Klein-s-Playground/octo-pcb/README.md

# octo-pcb
KiCAD projects for PCB design files
