Klein-s-Playground/octo-pcb/diff-rcvr/README.md

# diff-rcvr

Single unidirectional RS-485/RS-422 differential to single-ended receiver.

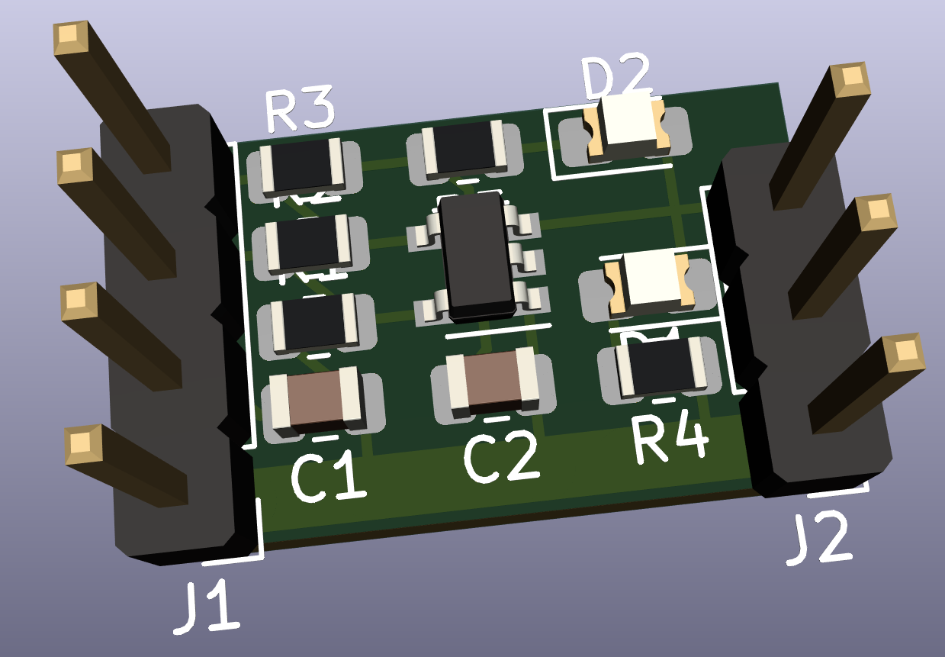
[picture p5: diff-rcvr/img/diff-rcvr_3d.png]
diff-rvcr_3d


This 10x20mm PCB is designed to be soldered on or near a strip of WS2812B programmable LEDs to increase the range and improve noise immunity on the data line.

| Schematic | PCB Layout |
:-------------------------:|:-------------------------:
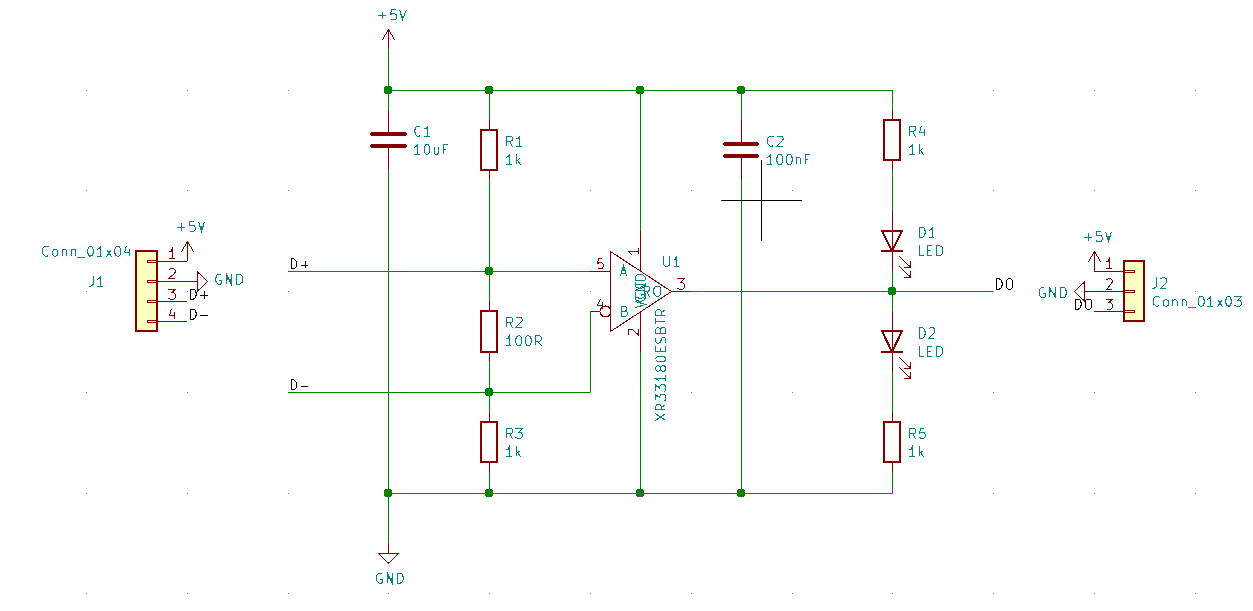
[picture p6: diff-rcvr/img/diff-rcvr_sch.png]
diff-rvcr_sch
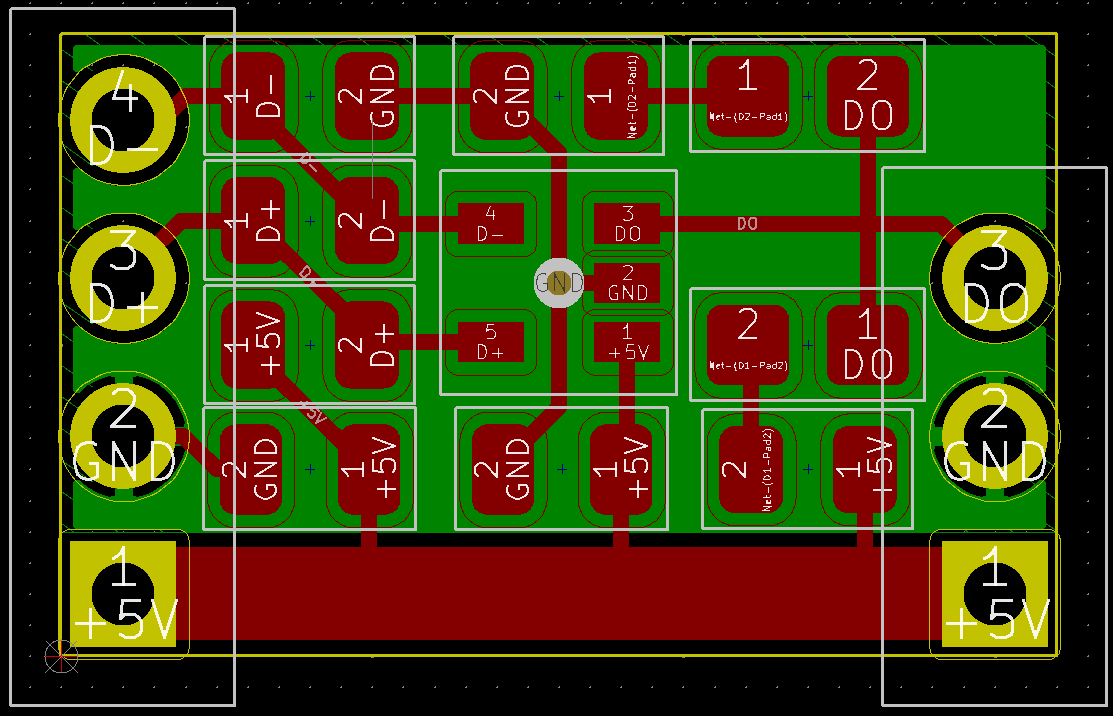
[picture p7: diff-rcvr/img/diff-rcvr_brd.png]
diff-rvcr_brd
 |
