Klein-s-Playground/octo-pcb/quad-diff-drvr/img/quad-diff-drvr.pdf

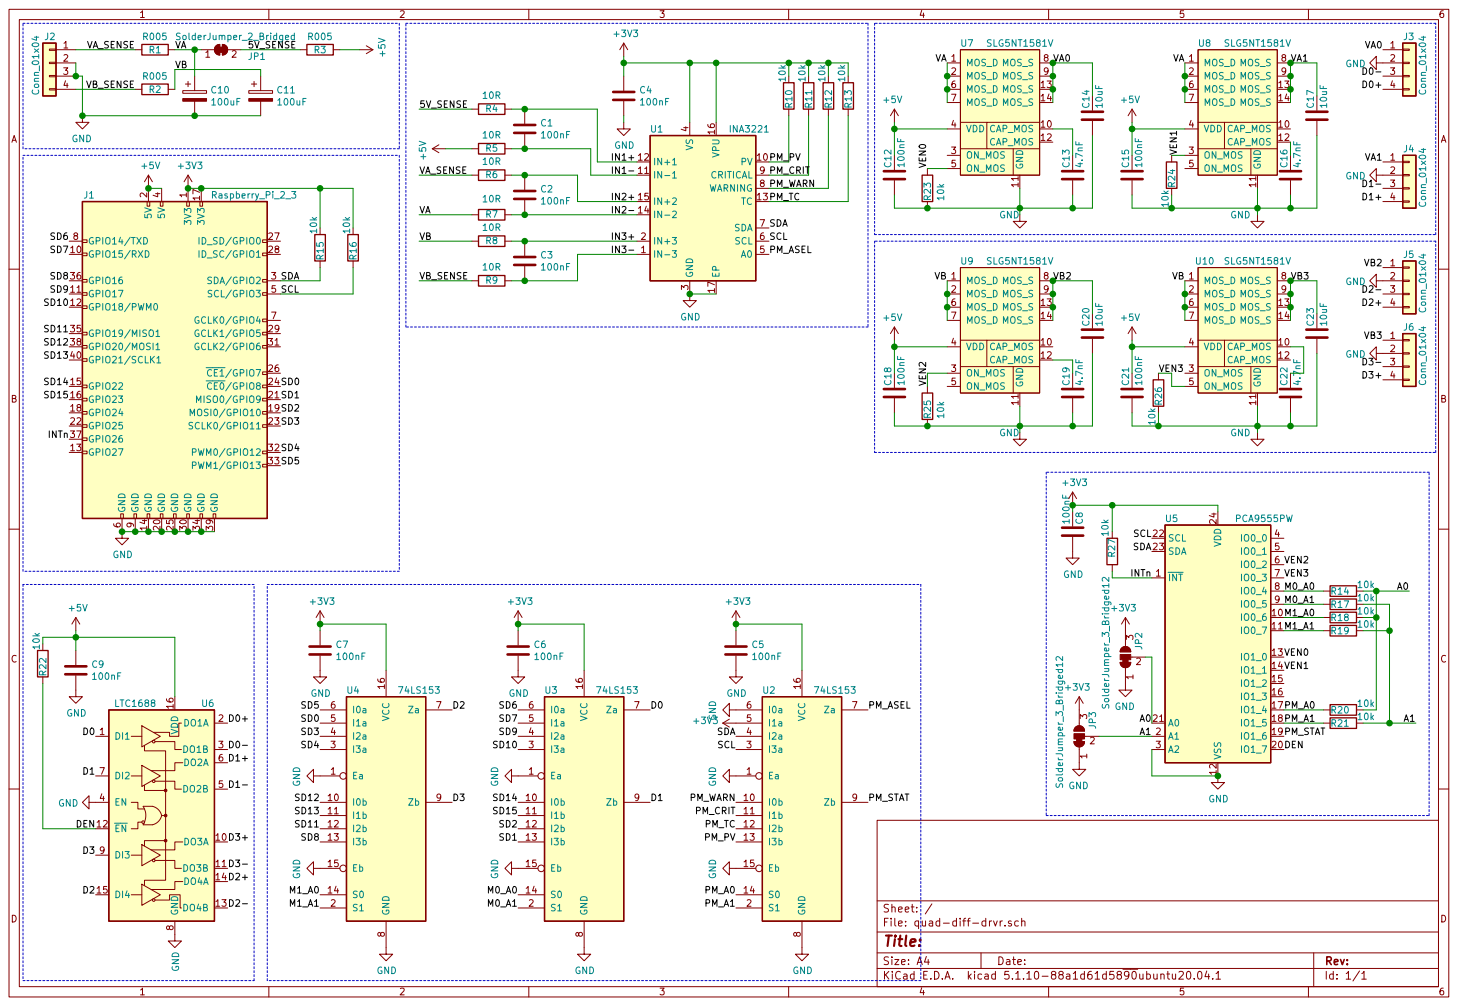
[picture p8: page 1]

3 JP3 SolderJumper_3_Bridged12 R14 10k R17 10k R18 10k R19 10k GND C12 100nF GND GND GND C13 4.7nF GND MOS_D 1 CAP_MOS 10 GND 11 CAP_MOS 12 MOS_S 13 MOS_S 14 MOS_D 2 ON_MOS 3 VDD 4 ON_MOS 5 MOS_D 6 MOS_D 7 MOS_S 8 MOS_S 9 U7 SLG5NT1581V

4 A0 5 SCL 6 SDA 7 WARNING 8 CRITICAL 9 U1 INA3221 R10 10k

File: quad-diff-drvr.sch Sheet: /
Rev: | D Date: KiCad E.D.A. kicad 5.1.10-88a1d61d5890ubuntu20.04.1 Size: A4
