Klein-s-Playground/octo-pcb/quad-diff-drvr/quad-diff-drvr.kicad_pcb

## KiCad design quad-diff-drvr/quad-diff-drvr.kicad_pcb (2022-01-29)

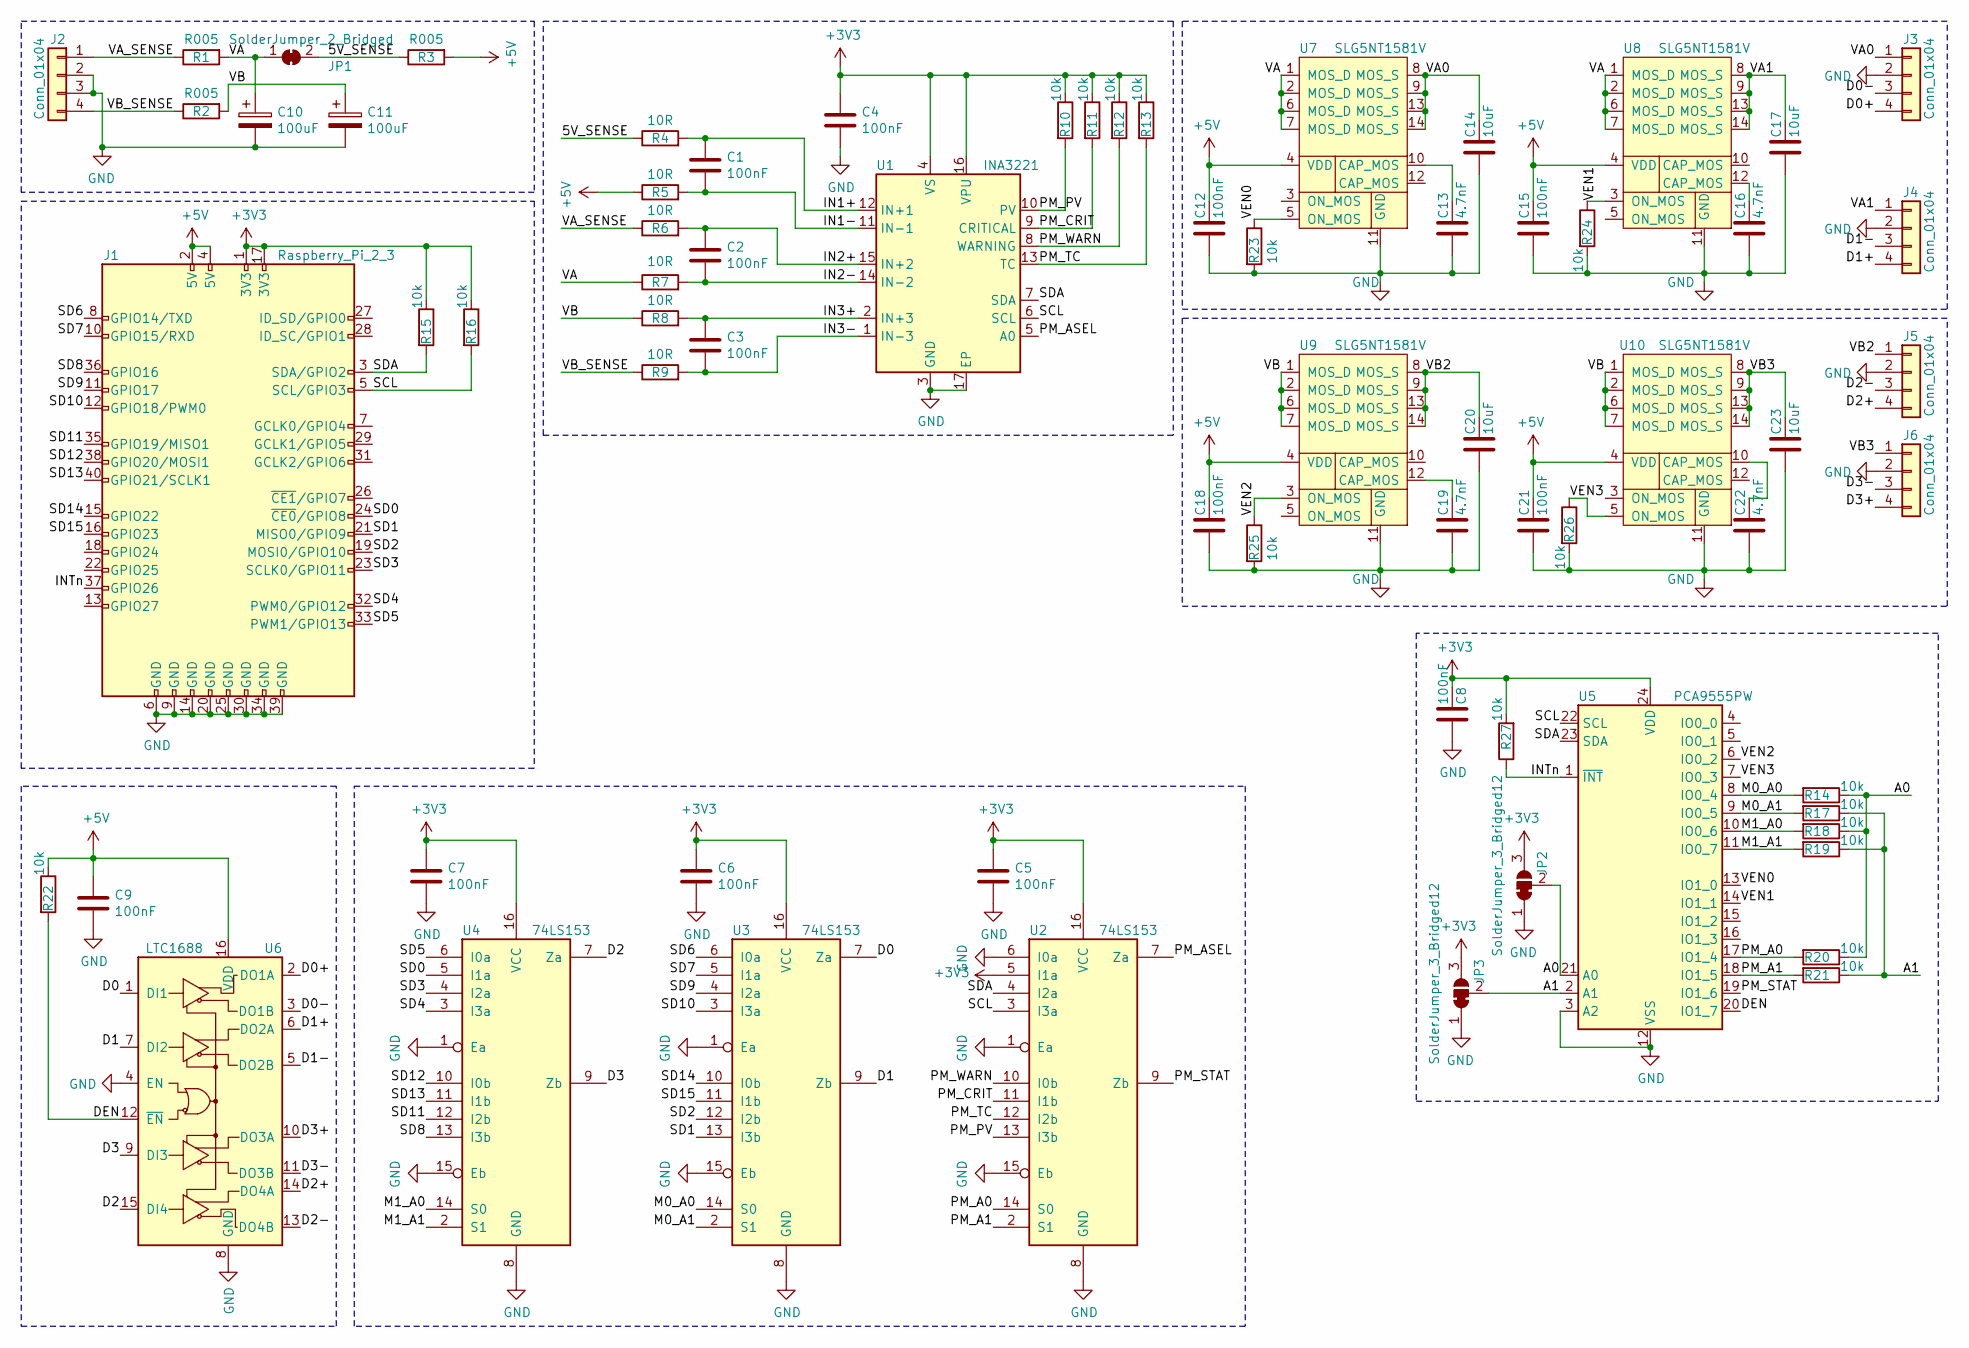
[picture p9: schematic quad-diff-drvr.sch]

Parts:
C1, C2, C3, C4, C5, C6, C7, C8, C9, C12, C15, C18, C21: 100nF; C_0603_1608Metric
C10, C11: 100uF; CP_Elec_6.3x7.7
C13, C16, C19, C22: 4.7nF; C_0603_1608Metric
C14, C17, C20, C23: 10uF; C_1206_3216Metric
J1: Raspberry_Pi_2_3; PinHeader_2x20_P2.54mm_Vertical
J2, J3, J4, J5, J6: Conn_01x04; PhoenixContact_MSTBA_2,5_4-G_1x04_P5.00mm_Horizontal
JP1: SolderJumper_2_Bridged; SolderJumper-2_P1.3mm_Bridged2Bar_RoundedPad1.0x1.5mm
JP2, JP3: SolderJumper_3_Bridged12; SolderJumper-3_P1.3mm_Bridged2Bar12_RoundedPad1.0x1.5mm
R1, R2, R3: R005; R_1206_3216Metric
R4, R5, R6, R7, R8, R9: 10R; R_0603_1608Metric
R10, R11, R12, R13, R14, R15, R16, R17, R18, R19, R20, R21, R22, R23, R24, R25, R26, R27: 10k; R_0603_1608Metric
U1: INA3221; Texas_RGV_S-PVQFN-N16_EP2.1x2.1mm
U2, U3, U4: 74LS153; TSSOP-16_4.4x5mm_P0.65mm
U5: PCA9555PW; TSSOP-24_4.4x7.8mm_P0.65mm
U6: LTC1688; SOIC-16_3.9x9.9mm_P1.27mm
U7, U8, U9, U10: SLG5NT1581V; QFN-28_1x3_Pitch0.4mm

Connections:
+3V3: C4.1, C5.1, C6.1, C7.1, C8.1, J1.1 (3V3), J1.17 (3V3), JP2.3 (B), JP3.3 (B), R10.1, R11.1, R12.1, R13.1, R15.1, R16.1, R27.2, U1.4 (VS), U1.16 (VPU), U2.5 (I1a), U2.16 (VCC), U3.16 (VCC), U4.16 (VCC), U5.24 (VDD)
+5V: C9.1, C12.1, C15.1, C18.1, C21.1, J1.2 (5V), J1.4 (5V), R3.2, R5.1, R22.1, U6.16 (VDD), U7.4 (VDD), U8.4 (VDD), U9.4 (VDD), U10.4 (VDD)
/5V_SENSE: JP1.2 (B), R3.1, R4.1
/A0: JP2.2 (C), R14.1, R18.1, R20.1, U5.21 (A0)
/A1: JP3.2 (C), R17.1, R19.1, R21.1, U5.2 (A1)
/D0: U3.7 (Za), U6.1 (DI1)
/D0+: J3.4, U6.2 (DO1A)
/D0-: J3.3, U6.3 (DO1B)
/D1: U3.9 (Zb), U6.7 (DI2)
/D1+: J4.4, U6.6 (DO2A)
/D1-: J4.3, U6.5 (DO2B)
/D2: U4.7 (Za), U6.15 (DI4)
/D2+: J5.4, U6.14 (DO4A)
/D2-: J5.3, U6.13 (DO4B)
/D3: U4.9 (Zb), U6.9 (DI3)
/D3+: J6.4, U6.10 (DO3A)
/D3-: J6.3, U6.11 (DO3B)
/DEN: R22.2, U5.20 (IO1_7), U6.12 (~EN)
/IN1+: C1.1, R4.2, U1.12 (IN+1)
/IN1-: C1.2, R5.2, U1.11 (IN-1)
/IN2+: C2.1, R6.2, U1.15 (IN+2)
/IN2-: C2.2, R7.2, U1.14 (IN-2)
/IN3+: C3.1, R8.2, U1.2 (IN+3)
/IN3-: C3.2, R9.2, U1.1 (IN-3)
/INTn: J1.37 (GPIO26), R27.1, U5.1 (~INT)
/M0_A0: R14.2, U3.14 (S0), U5.8 (IO0_4)
/M0_A1: R17.2, U3.2 (S1), U5.9 (IO0_5)
/M1_A0: R18.2, U4.14 (S0), U5.10 (IO0_6)
/M1_A1: R19.2, U4.2 (S1), U5.11 (IO0_7)
/PM_A0: R20.2, U2.14 (S0), U5.17 (IO1_4)
/PM_A1: R21.2, U2.2 (S1), U5.18 (IO1_5)
/PM_ASEL: U1.5 (A0), U2.7 (Za)
/PM_CRIT: R11.2, U1.9 (CRITICAL), U2.11 (I1b)
/PM_PV: R10.2, U1.10 (PV), U2.13 (I3b)
/PM_STAT: U2.9 (Zb), U5.19 (IO1_6)
/PM_TC: R13.2, U1.13 (TC), U2.12 (I2b)
/PM_WARN: R12.2, U1.8 (WARNING), U2.10 (I0b)
/SCL: J1.5 (SCL/GPIO3), R16.2, U1.6 (SCL), U2.3 (I3a), U5.22 (SCL)
/SD0: J1.24 (~CE0~/GPIO8), U4.5 (I1a)
/SD1: J1.21 (MISO0/GPIO9), U3.13 (I3b)
/SD2: J1.19 (MOSI0/GPIO10), U3.12 (I2b)
/SD3: J1.23 (SCLK0/GPIO11), U4.4 (I2a)
/SD4: J1.32 (PWM0/GPIO12), U4.3 (I3a)
/SD5: J1.33 (PWM1/GPIO13), U4.6 (I0a)
/SD6: J1.8 (GPIO14/TXD), U3.6 (I0a)
/SD7: J1.10 (GPIO15/RXD), U3.5 (I1a)
/SD8: J1.36 (GPIO16), U4.13 (I3b)
/SD9: J1.11 (GPIO17), U3.4 (I2a)
/SD10: J1.12 (GPIO18/PWM0), U3.3 (I3a)
/SD11: J1.35 (GPIO19/MISO1), U4.12 (I2b)
/SD12: J1.38 (GPIO20/MOSI1), U4.10 (I0b)
/SD13: J1.40 (GPIO21/SCLK1), U4.11 (I1b)
/SD14: J1.15 (GPIO22), U3.10 (I0b)
/SD15: J1.16 (GPIO23), U3.11 (I1b)
/SDA: J1.3 (SDA/GPIO2), R15.2, U1.7 (SDA), U2.4 (I2a), U5.23 (SDA)
/VA: C10.1, JP1.1 (A), R1.2, R7.1, U7.1 (MOS_D), U7.2 (MOS_D), U7.6 (MOS_D), U7.7 (MOS_D), U8.1 (MOS_D), U8.2 (MOS_D), U8.6 (MOS_D), U8.7 (MOS_D)
/VA0: C14.1, J3.1, U7.8 (MOS_S), U7.9 (MOS_S), U7.13 (MOS_S), U7.14 (MOS_S)
/VA1: C17.1, J4.1, U8.8 (MOS_S), U8.9 (MOS_S), U8.13 (MOS_S), U8.14 (MOS_S)
/VA_SENSE: J2.1, R1.1, R6.1
/VB: C11.1, R2.2, R8.1, U9.1 (MOS_D), U9.2 (MOS_D), U9.6 (MOS_D), U9.7 (MOS_D), U10.1 (MOS_D), U10.2 (MOS_D), U10.6 (MOS_D), U10.7 (MOS_D)
/VB2: C20.1, J5.1, U9.8 (MOS_S), U9.9 (MOS_S), U9.13 (MOS_S), U9.14 (MOS_S)
/VB3: C23.1, J6.1, U10.8 (MOS_S), U10.9 (MOS_S), U10.13 (MOS_S), U10.14 (MOS_S)
/VB_SENSE: J2.4, R2.1, R9.1
/VEN0: R23.1, U5.13 (IO1_0), U7.5 (ON_MOS)
/VEN1: R24.1, U5.14 (IO1_1), U8.3 (ON_MOS)
/VEN2: R25.1, U5.6 (IO0_2), U9.3 (ON_MOS)
/VEN3: R26.1, U5.7 (IO0_3), U10.5 (ON_MOS)
GND: C4.2, C5.2, C6.2, C7.2, C8.2, C9.2, C10.2, C11.2, C12.2, C13.2, C14.2, C15.2, C16.2, C17.2, C18.2, C19.2, C20.2, C21.2, C22.2, C23.2, J1.6 (GND), J1.9 (GND), J1.14 (GND), J1.20 (GND), J1.25 (GND), J1.30 (GND), J1.34 (GND), J1.39 (GND), J2.2, J2.3, J3.2, J4.2, J5.2, J6.2, JP2.1 (A), JP3.1 (A), R23.2, R24.2, R25.2, R26.2, U1.3 (GND), U1.17 (EP), U2.1 (Ea), U2.6 (I0a), U2.8 (GND), U2.15 (Eb), U3.1 (Ea), U3.8 (GND), U3.15 (Eb), U4.1 (Ea), U4.8 (GND), U4.15 (Eb), U5.3 (A2), U5.12 (VSS), U6.4 (EN), U6.8 (GND), U7.11 (GND), U8.11 (GND), U9.11 (GND), U10.11 (GND)
unnamed: C13.1, U7.10 (CAP_MOS)
unnamed: C16.1, U8.12 (CAP_MOS)
unnamed: C19.1, U9.12 (CAP_MOS)
unnamed: C22.1, U10.10 (CAP_MOS)

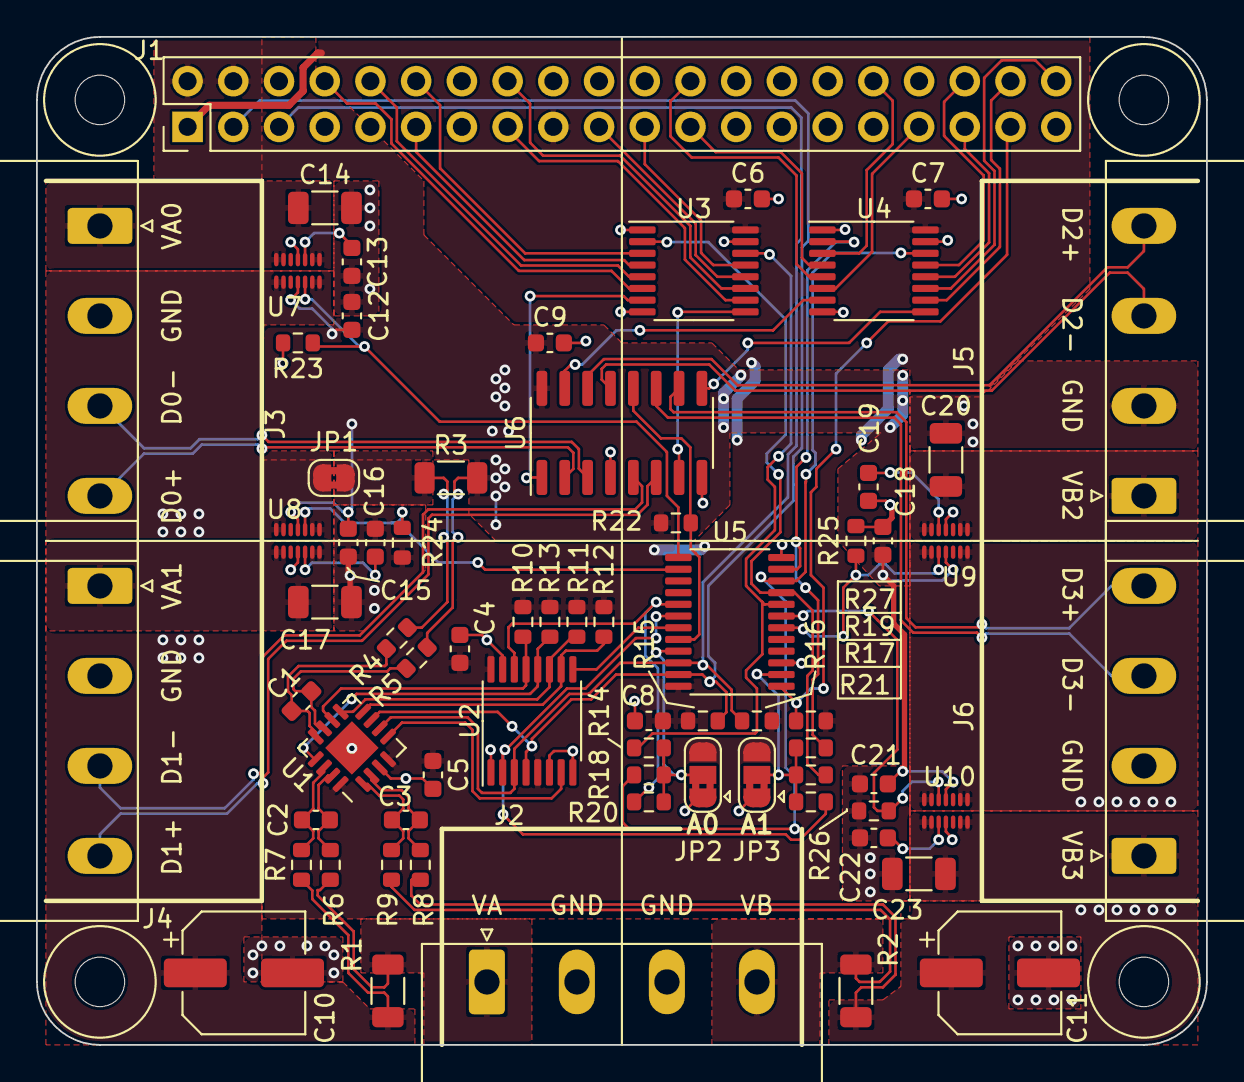
[picture p10: board quad-diff-drvr.kicad_pcb from above]

Board: 2 copper layers, 65.0 x 56.0 mm, 69 parts (0 on the bottom side), 72 nets.
