Klein-s-Playground/octo-pcb/diff-rcvr/diff-rcvr.kicad_pcb

## KiCad design diff-rcvr/diff-rcvr.kicad_pcb (2022-01-18)

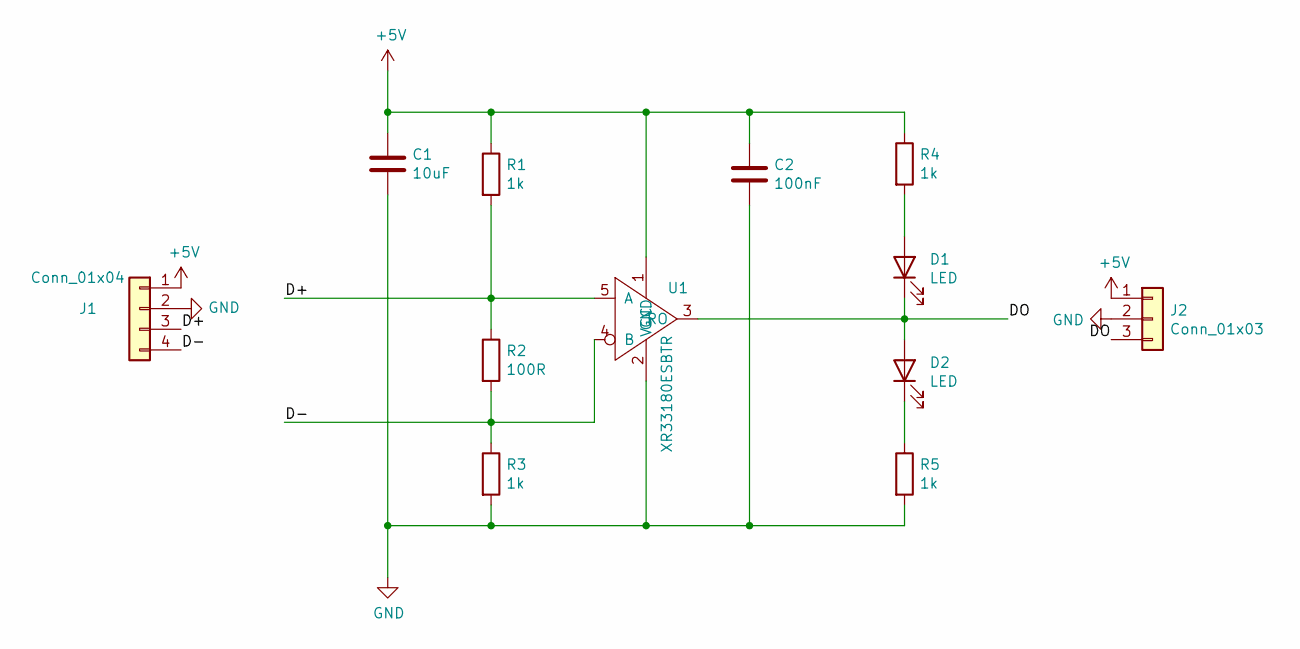
[picture p11: schematic diff-rcvr.sch]

Parts:
C1: 10uF; C_0805_2012Metric
C2: 100nF; C_0805_2012Metric
D1, D2: LED; LED_0805_2012Metric_Castellated
J1: Conn_01x04; PinHeader_1x04_P2.54mm_Vertical
J2: Conn_01x03; PinHeader_1x03_P2.54mm_Vertical
R1, R3, R4, R5: 1k; R_0805_2012Metric
R2: 100R; R_0805_2012Metric
U1: XR33180ESBTR; SOT-23-5

Connections:
+5V: C1.1, C2.1, J1.1, J2.1, R1.1, R4.1, U1.1 (VCC)
/D+: J1.3, R1.2, R2.1, U1.5 (A)
/D-: J1.4, R2.2, R3.1, U1.4 (B)
/DO: D1.1 (K), D2.2 (A), J2.3, U1.3 (RO)
GND: C1.2, C2.2, J1.2, J2.2, R3.2, R5.2, U1.2 (GND)
unnamed: D1.2 (A), R4.2
unnamed: D2.1 (K), R5.1

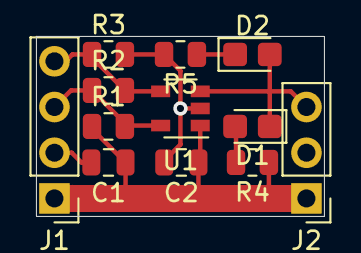
[picture p12: board diff-rcvr.kicad_pcb from above]

Board: 2 copper layers, 16.0 x 10.0 mm, 12 parts (0 on the bottom side), 7 nets.
