Klein-s-Playground/octo-pcb/(commit log)

2022-01-18 diff-rcvf: first commit
    [diff-rcvr.kicad_pcb, diff-rcvr.sch]
2022-01-22 qdd: basic mechanical layout done
    [quad-diff-drvr.kicad_pcb, quad-diff-drvr.sch]
2022-01-22 qdd: power monitor added
    [quad-diff-drvr.kicad_pcb, quad-diff-drvr.sch]
2022-01-22 qdd: add mux0 and mux1
    [quad-diff-drvr.kicad_pcb, quad-diff-drvr.sch]
2022-01-22 qd: GPIO expander in
    [quad-diff-drvr.kicad_pcb, quad-diff-drvr.sch]
2022-01-22 qdd: driver added
    [quad-diff-drvr.kicad_pcb, quad-diff-drvr.sch]
2022-01-24 qdd: first pass at routing
    [quad-diff-drvr.kicad_pcb, quad-diff-drvr.sch]
2022-01-24 qdd: adding high-side switch
    [quad-diff-drvr.sch]
2022-01-25 qdd: unsure what got out of sync
    [quad-diff-drvr.kicad_pcb, quad-diff-drvr.sch]
2022-01-25 qdd: stash wip
    [quad-diff-drvr.kicad_pcb, quad-diff-drvr.sch]
2022-01-26 qdd: two high-side switches in
    [quad-diff-drvr.kicad_pcb, quad-diff-drvr.sch]
2022-01-26 qdd: VB high side switches
    [quad-diff-drvr.kicad_pcb, quad-diff-drvr.sch]
2022-01-27 qdd: quick and dirty route done
    [quad-diff-drvr.kicad_pcb, quad-diff-drvr.sch]
2022-01-29 qdd: cleaned up silkscreen
    [quad-diff-drvr.kicad_pcb]
